scts-engineering/umptysquatch-10/electronics/new_electronics/new_electronics.pdf

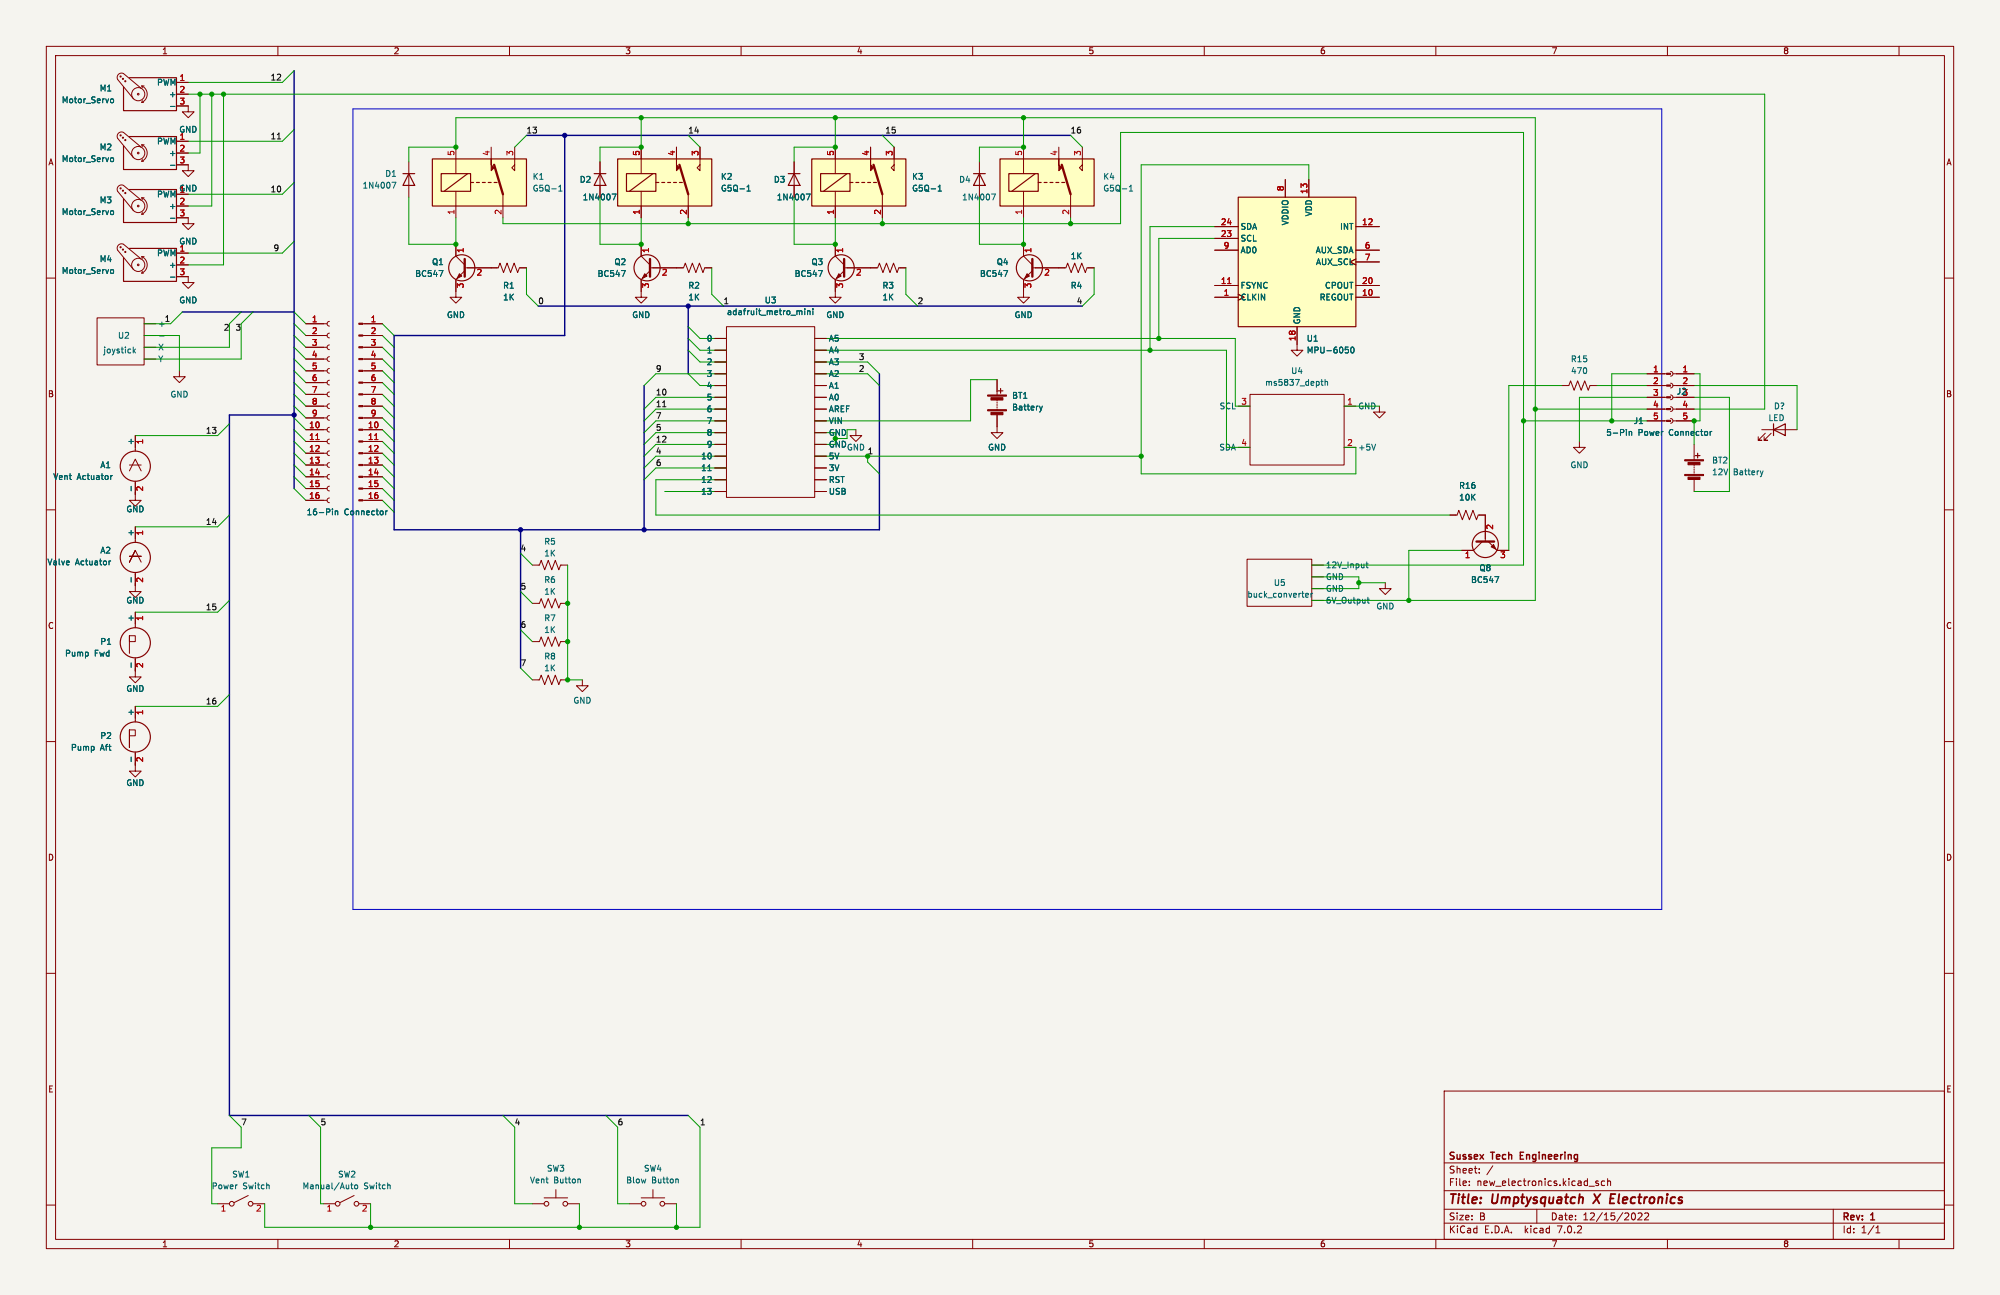
[picture p1: page 1]

Id: 1/1 Title: Umptysquatch X Electronics
