scts-engineering/umptysquatch-10/electronics/integrated_joystick_dac/integrated_joystick_dac.kicad_pcb

## KiCad design electronics/integrated_joystick_dac/integrated_joystick_dac.kicad_pcb (2023-05-17)

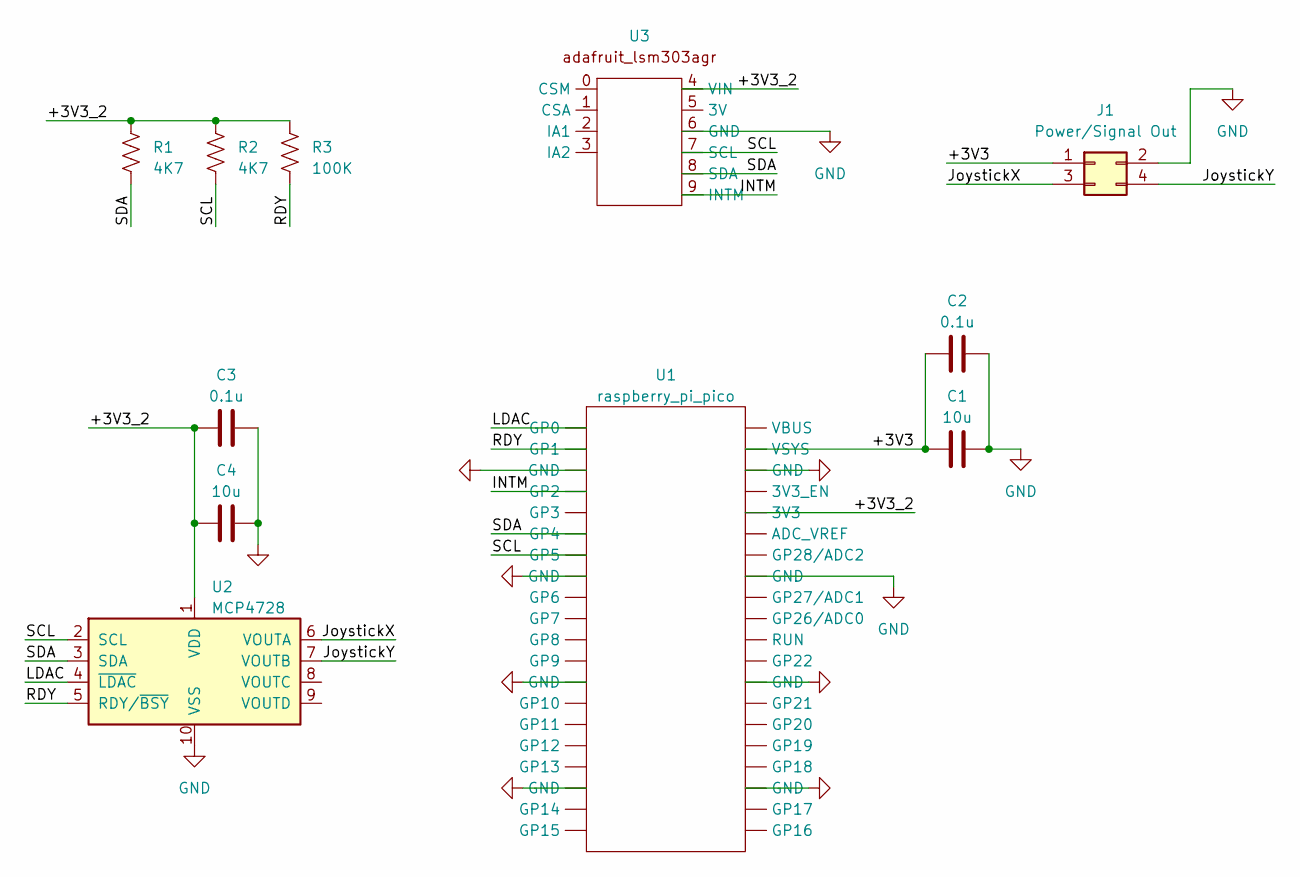
[picture p2: schematic integrated_joystick_dac.kicad_sch, Joystick DAC Board - Schematic]

Parts:
C1, C4: 10u; C_0603_1608Metric_Pad1.08x0.95mm_HandSolder
C2, C3: 0.1u; C_0402_1005Metric_Pad0.74x0.62mm_HandSolder
J1: Power/Signal Out; Molex_Mini-Fit_Jr_5569-04A2_2x02_P4.20mm_Horizontal
R1, R2: 4K7; R_Axial_DIN0207_L6.3mm_D2.5mm_P10.16mm_Horizontal
R3: 100K; R_Axial_DIN0207_L6.3mm_D2.5mm_P10.16mm_Horizontal
U1: raspberry_pi_pico
U2: MCP4728; MSOP-10_3x3mm_P0.5mm
U3: adafruit_lsm303agr

Connections:
/+3V3: C1.1, C2.1, J1.1, U1.39 (VSYS)
/+3V3_2: C3.1, C4.1, R1.1, R2.1, R3.1, U1.36 (3V3), U2.1 (VDD), U3.4 (VIN)
/INTM: U1.4 (GP2), U3.9 (INTM)
/JoystickX: J1.3, U2.6 (VOUTA)
/JoystickY: J1.4, U2.7 (VOUTB)
/LDAC: U1.1 (GP0), U2.4 (~LDAC)
/RDY: R3.2, U1.2 (GP1), U2.5 (RDY/~BSY)
/SCL: R2.2, U1.7 (GP5), U2.2 (SCL), U3.7 (SCL)
/SDA: R1.2, U1.6 (GP4), U2.3 (SDA), U3.8 (SDA)
GND: C1.2, C2.2, C3.2, C4.2, J1.2, U1.3 (GND), U1.8 (GND), U1.13 (GND), U1.18 (GND), U1.23 (GND), U1.28 (GND), U1.33 (GND), U1.38 (GND), U2.10 (VSS), U3.6 (GND)

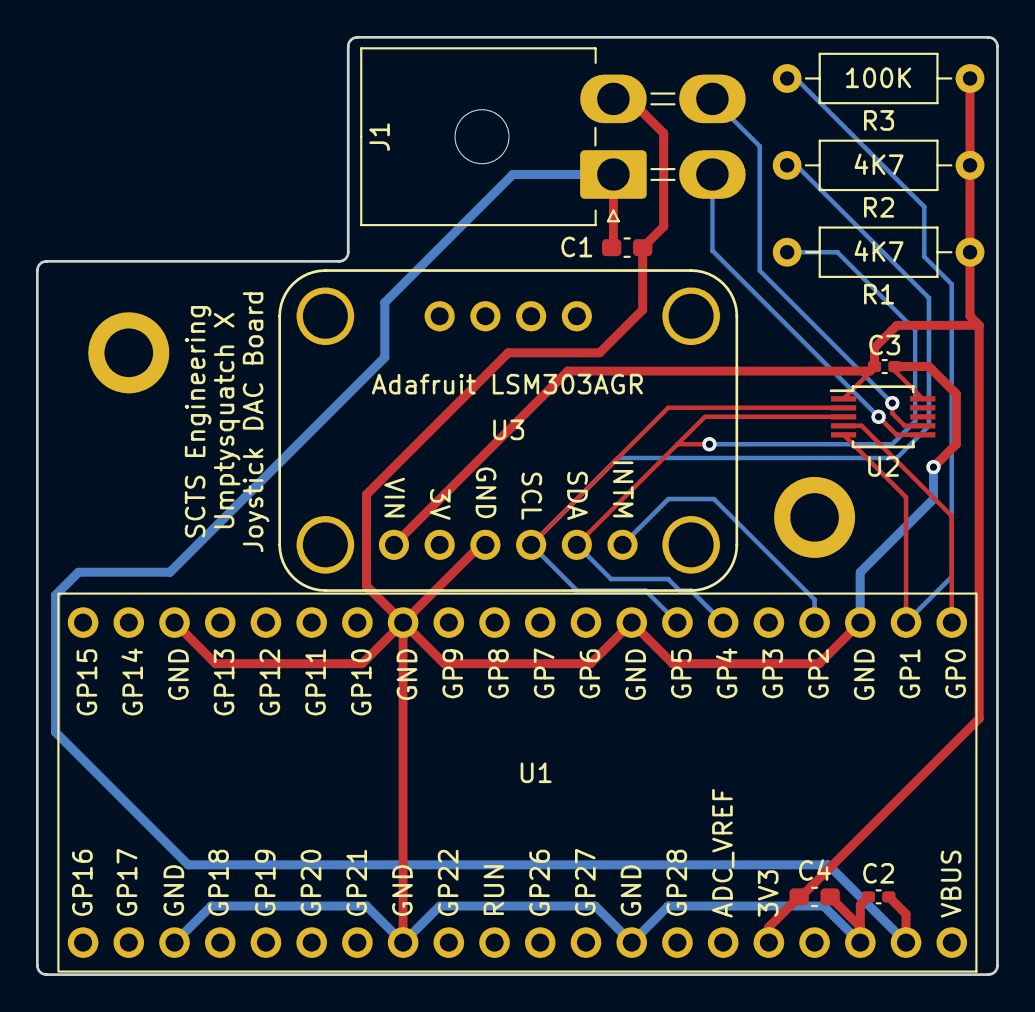
[picture p3: board integrated_joystick_dac.kicad_pcb from above]

Board: 2 copper layers, 53.3 x 52.1 mm, 11 parts (0 on the bottom side), 10 nets.
