scts-engineering/umptysquatch-10/electronics/v2_electronics/v2_electronics.kicad_pcb

## KiCad design electronics/v2_electronics/v2_electronics.kicad_pcb (2023-05-17)

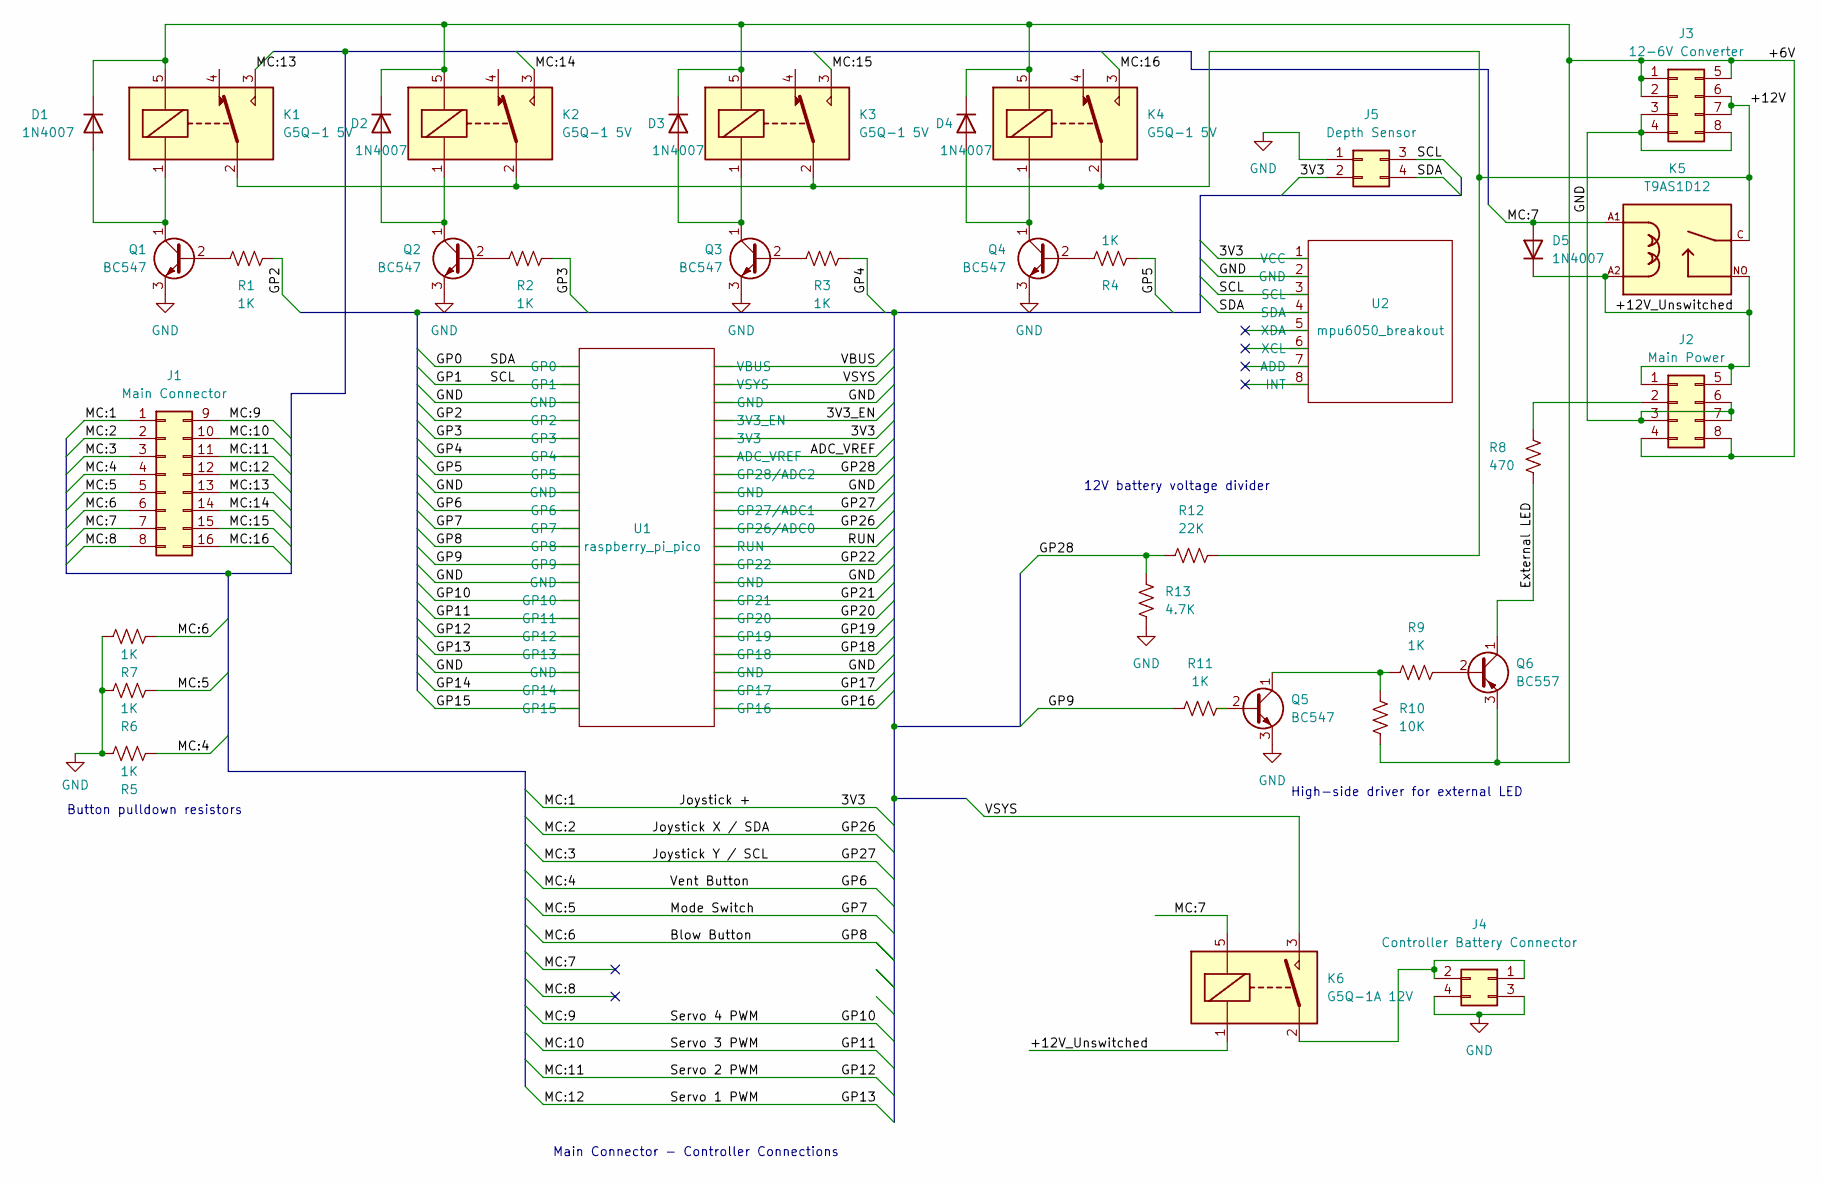
[picture p4: schematic v2_electronics.kicad_sch, Umptysquatch X Electronics]

Parts:
D1, D2, D3, D4: 1N4007; D_DO-41_SOD81_P12.70mm_Horizontal
D5: 1N4007; D_DO-41_SOD81_P10.16mm_Horizontal
J1: Main Connector; Molex_Mini-Fit_Jr_5569-16A2_2x08_P4.20mm_Horizontal
J2: Main Power; Molex_Mini-Fit_Jr_5569-08A2_2x04_P4.20mm_Horizontal
J3: 12-6V Converter; Molex_Mini-Fit_Jr_5569-08A2_2x04_P4.20mm_Horizontal
J4: Controller Battery Connector; Molex_Mini-Fit_Jr_5569-04A2_2x02_P4.20mm_Horizontal
J5: Depth Sensor; Molex_Mini-Fit_Jr_5569-04A2_2x02_P4.20mm_Horizontal
K1, K2, K3, K4: G5Q-1 5V; Relay_SPDT_Omron-G5Q-1
K5: T9AS1D12
K6: G5Q-1A 12V; Relay_SPST_Omron-G5Q-1A
Q1, Q2, Q3, Q4, Q5: BC547; TO-92_Inline
Q6: BC557; TO-92_Inline
R1, R2, R3, R4, R5, R6, R7, R9, R11: 1K; R_Axial_DIN0207_L6.3mm_D2.5mm_P10.16mm_Horizontal
R8: 470; R_Axial_DIN0207_L6.3mm_D2.5mm_P10.16mm_Horizontal
R10: 10K; R_Axial_DIN0207_L6.3mm_D2.5mm_P10.16mm_Horizontal
R12: 22K; R_Axial_DIN0207_L6.3mm_D2.5mm_P10.16mm_Horizontal
R13: 4.7K; R_Axial_DIN0207_L6.3mm_D2.5mm_P10.16mm_Horizontal
U1: raspberry_pi_pico
U2: mpu6050_breakout; mpu6050

Connections:
/3V3: J1.1, J5.2, U1.36 (3V3), U2.1 (VCC)
/3V3_EN: U1.37 (3V3_EN); also elsewhere on the board
/+6V: D1.1 (K), D2.1 (K), D3.1 (K), D4.1 (K), J2.4, J2.8, J3.1, J3.2, J3.5, K1.5, K2.5, K3.5, K4.5, Q6.3 (E), R10.1
/+12V: J3.6, J3.7, K1.2, K2.2, K3.2, K4.2, K5.C, R12.2
/+12V_Unswitched: D5.1 (K), J2.1, J2.5, K5.A2, K5.NO, K6.1
/ADC_VREF: U1.35 (ADC_VREF); also elsewhere on the board
/Blow Button: J1.6, R7.2, U1.11 (GP8)
/External LED: Q6.1 (C), R8.1
/GP0: J5.4, U1.1 (GP0), U2.4 (SDA)
/GP1: J5.3, U1.2 (GP1), U2.3 (SCL)
/GP2: R1.2, U1.4 (GP2)
/GP3: R2.2, U1.5 (GP3)
/GP4: R3.2, U1.6 (GP4)
/GP5: R4.2, U1.7 (GP5)
/GP6: J1.4, R5.2, U1.9 (GP6)
/GP7: J1.5, R6.2, U1.10 (GP7)
/GP9: R11.1, U1.12 (GP9)
/GP10: J1.9, U1.14 (GP10)
/GP11: J1.10, U1.15 (GP11)
/GP12: J1.11, U1.16 (GP12)
/GP13: J1.12, U1.17 (GP13)
/GP14: U1.19 (GP14); also elsewhere on the board
/GP15: U1.20 (GP15); also elsewhere on the board
/GP16: U1.21 (GP16); also elsewhere on the board
/GP17: U1.22 (GP17); also elsewhere on the board
/GP18: U1.24 (GP18); also elsewhere on the board
/GP19: U1.25 (GP19); also elsewhere on the board
/GP20: U1.26 (GP20); also elsewhere on the board
/GP21: U1.27 (GP21); also elsewhere on the board
/GP22: U1.29 (GP22); also elsewhere on the board
/GP26: J1.2, U1.31 (GP26/ADC0)
/GP27: J1.3, U1.32 (GP27/ADC1)
/GP28: R12.1, R13.2, U1.34 (GP28/ADC2)
/MC:7: D5.2 (A), J1.7, K5.A1, K6.5
/MC:8: J1.8
/MC:13: J1.13, K1.3
/MC:14: J1.14, K2.3
/MC:15: J1.15, K3.3
/MC:16: J1.16, K4.3
/RUN: U1.30 (RUN); also elsewhere on the board
/VBUS: U1.40 (VBUS); also elsewhere on the board
/VSYS: K6.3, U1.39 (VSYS)
GND: J2.3, J2.6, J2.7, J3.3, J3.4, J3.8, J4.3, J4.4, J5.1, Q1.3 (E), Q2.3 (E), Q3.3 (E), Q4.3 (E), Q5.3 (E), R5.1, R6.1, R7.1, R13.1, U1.3 (GND), U1.8 (GND), U1.13 (GND), U1.18 (GND), U1.23 (GND), U1.28 (GND), U1.33 (GND), U1.38 (GND), U2.2 (GND)
unnamed: D1.2 (A), K1.1, Q1.1 (C)
unnamed: D2.2 (A), K2.1, Q2.1 (C)
unnamed: D3.2 (A), K3.1, Q3.1 (C)
unnamed: D4.2 (A), K4.1, Q4.1 (C)
unnamed: J2.2, R8.2
unnamed: J4.1, J4.2, K6.2
unnamed: Q1.2 (B), R1.1
unnamed: Q2.2 (B), R2.1
unnamed: Q3.2 (B), R3.1
unnamed: Q4.2 (B), R4.1
unnamed: Q5.1 (C), R9.1, R10.2
unnamed: Q5.2 (B), R11.2
unnamed: Q6.2 (B), R9.2

Notes on the sheet:
12V battery voltage divider
Main Connector - Controller Connections
Button pulldown resistors
High-side driver for external LED

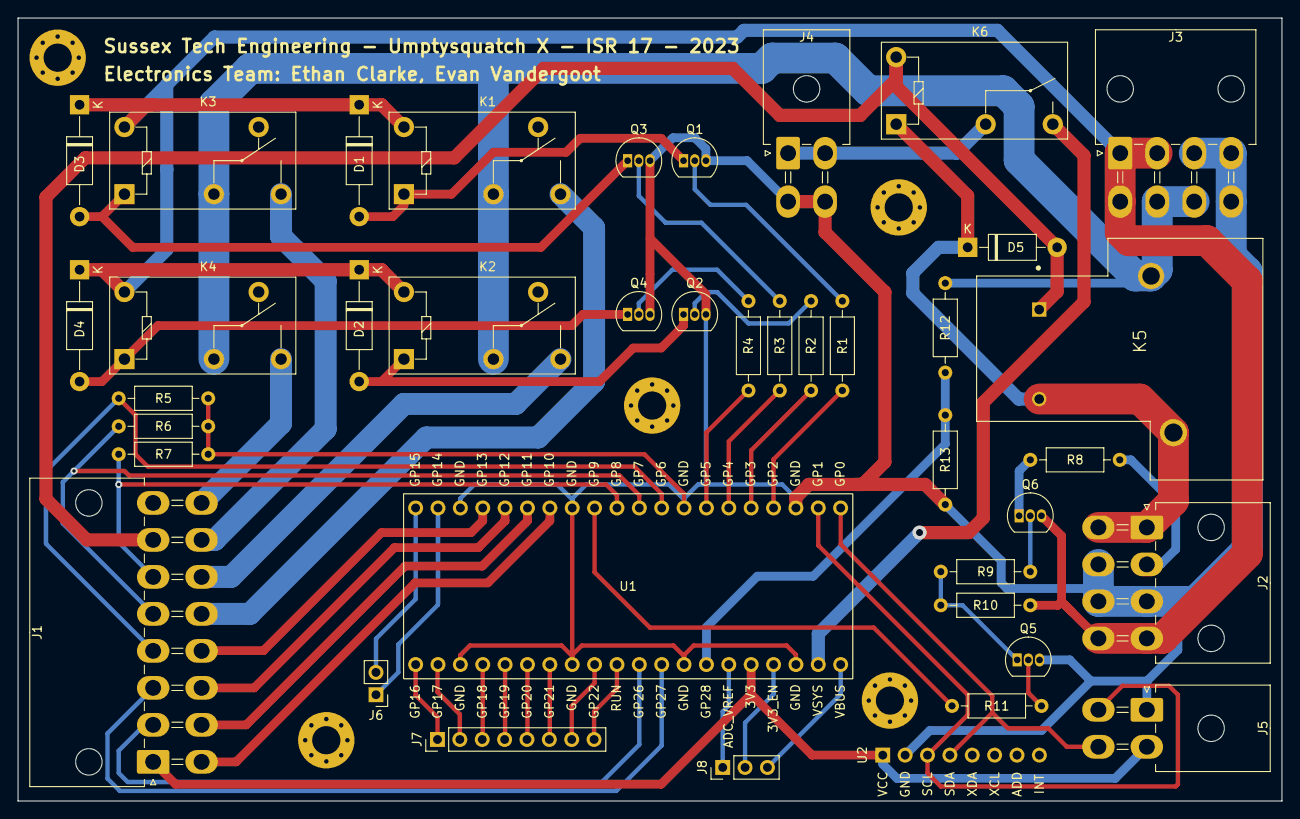
[picture p5: board v2_electronics.kicad_pcb from above]

Board: 2 copper layers, 143.5 x 88.9 mm, 40 parts (0 on the bottom side), 55 nets.

Other parts of the board:
J6: PinHeader_1x02_P2.54mm_Vertical
J7: PinHeader_1x08_P2.54mm_Vertical
J8: PinHeader_1x03_P2.54mm_Vertical

Their connections:
/3V3_EN: J8.2; also elsewhere on the board
/ADC_VREF: J8.1; also elsewhere on the board
/GP14: J6.1; also elsewhere on the board
/GP15: J6.2; also elsewhere on the board
/GP16: J7.1; also elsewhere on the board
/GP17: J7.2; also elsewhere on the board
/GP18: J7.3; also elsewhere on the board
/GP19: J7.4; also elsewhere on the board
/GP20: J7.5; also elsewhere on the board
/GP21: J7.6; also elsewhere on the board
/GP22: J7.7; also elsewhere on the board
/RUN: J7.8; also elsewhere on the board
/VBUS: J8.3; also elsewhere on the board
