scts-engineering/umptysquatch-10/electronics/joystick_dac/joystick_dac.kicad_pcb

## KiCad design electronics/joystick_dac/joystick_dac.kicad_pcb (2023-05-08)

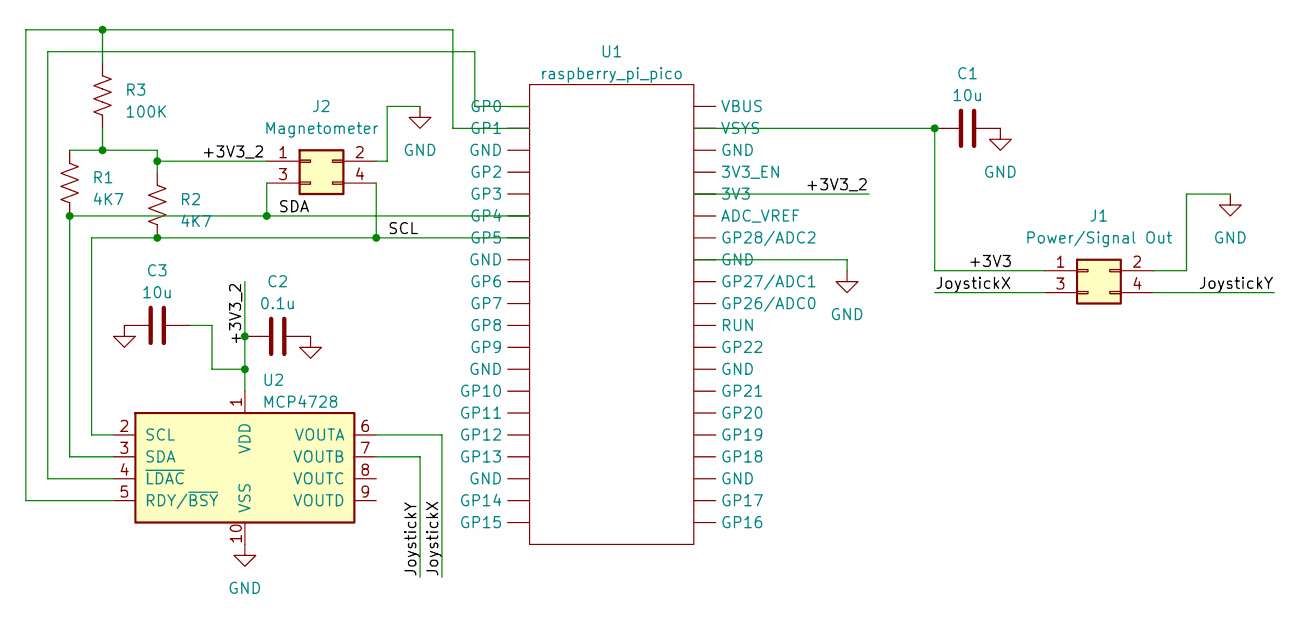
[picture p6: schematic joystick_dac.kicad_sch]

Parts:
C1, C3: 10u; C_0603_1608Metric_Pad1.08x0.95mm_HandSolder
C2: 0.1u; C_0402_1005Metric_Pad0.74x0.62mm_HandSolder
J1: Power/Signal Out; Molex_Mini-Fit_Jr_5569-04A2_2x02_P4.20mm_Horizontal
J2: Magnetometer; Molex_Mini-Fit_Jr_5569-04A2_2x02_P4.20mm_Horizontal
R1, R2: 4K7; R_Axial_DIN0207_L6.3mm_D2.5mm_P10.16mm_Horizontal
R3: 100K; R_Axial_DIN0207_L6.3mm_D2.5mm_P10.16mm_Horizontal
U1: raspberry_pi_pico
U2: MCP4728; MSOP-10_3x3mm_P0.5mm

Connections:
/+3V3: C1.1, J1.1, U1.39 (VSYS)
/+3V3_2: C2.1, C3.2, J2.1, R1.1, R2.1, R3.2, U1.36 (3V3), U2.1 (VDD)
/JoystickX: J1.3, U2.6 (VOUTA)
/JoystickY: J1.4, U2.7 (VOUTB)
/SCL: J2.4, R2.2, U1.7 (GP5), U2.2 (SCL)
/SDA: J2.3, R1.2, U1.6 (GP4), U2.3 (SDA)
GND: C1.2, C2.2, C3.1, J1.2, J2.2, U1.33 (GND), U2.10 (VSS)
unnamed: U1.1 (GP0), U2.4 (~LDAC)
unnamed: R3.1, U1.2 (GP1), U2.5 (RDY/~BSY)

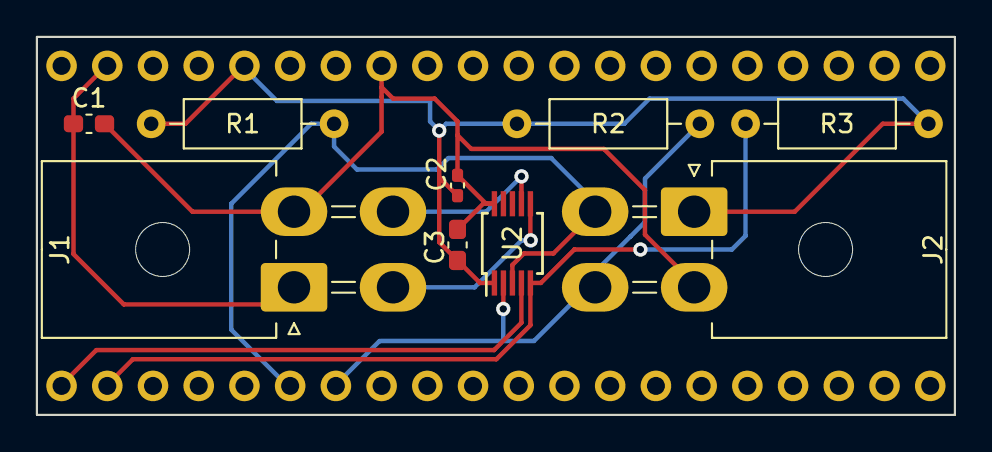
[picture p7: board joystick_dac.kicad_pcb from above]

Board: 2 copper layers, 51.0 x 21.0 mm, 10 parts (0 on the bottom side), 9 nets.
