scts-engineering/umptysquatch-10/code/u-10_code/sub-new-pi/buttons.h

#include <Arduino.h>

typedef struct DebouncedSwitch {
    long debounceDelay;
    int buttonState;
    int lastButtonState;
    int reading;
        
    int pinNum;
    // the function to run when state changes, with the int holding the new state
    void (*callback)(int);
} DebouncedSwitch;

void attachSwitch(DebouncedSwitch *sw, int pinNum, int debounceDelay, void (*callback)(int));

// returns true when there is a CHANGE in state,
// also runs the callback in the DebouncedSwitch
boolean tickSwitch(DebouncedSwitch *sw);
