scts-engineering/umptysquatch-10/(commit log)

2022-12-02 add remade old schematic
    [submarine.kicad_pcb, submarine.kicad_sch]
2022-12-02 make copy for new schematic and pcb
    [new_electronics.kicad_pcb, new_electronics.kicad_sch]
2022-12-05 'complete' old schematic and work on new one
    [new_electronics.kicad_sch, submarine.kicad_sch]
2022-12-06 more work on new schematic
    [new_electronics.kicad_sch, submarine.kicad_sch]
2022-12-07 work on new pcb
    [new_electronics.kicad_pcb, new_electronics.kicad_sch]
2022-12-09 some basic wiring for new pcb
    [new_electronics.kicad_pcb]
2022-12-11 more new pcb work
    [new_electronics.kicad_pcb, new_electronics.kicad_sch]
2022-12-14 'finished' new pcb
    [new_electronics.kicad_pcb]
2022-12-15 small changes still to new pcb
    [new_electronics.kicad_pcb]
2022-12-16 arduino wants sub-new.ino in a folder called sub-new
2022-12-22 do some stuff with steering and find out blocking code in mpu6050
2023-01-05 added some depth sensor stuff
2023-01-06 more work joystick magnet stuff
2023-01-10 pin selection and sucessful depth sensor tests
2023-01-13 organize folders
    [new_electronics.kicad_pcb, new_electronics.kicad_sch, submarine.kicad_pcb, submarine.kicad_sch]
2023-01-13 the servos and x pattern are good now
2023-01-18 added start to led test
2023-01-19 finished led example
2023-01-20 added led to main file
2023-01-30 led stuff
2023-02-03 button testing stuff
2023-02-03 fixed button pin numbers
    [sub-new.ino, submarine.h]
2023-02-05 added auto and manual mode switching
2023-02-06 Work on button switch system
2023-02-06 add magnetometer joystick test to git (for joystickrep)
2023-02-27 pico combatibility
2023-02-27 remove useless prints to console
2023-03-01 start v2 electronics schematic
    [v2_electronics.kicad_pcb, v2_electronics.kicad_sch]
2023-03-01 more work v2 electronics
    [v2_electronics.kicad_sch]
2023-03-03 switch debouncing
2023-03-08 more pcb v2 work:
    [v2_electronics.kicad_sch]
2023-03-09 more work on schematic v2
    [v2_electronics.kicad_sch]
2023-03-09 more work on v2 schematic:
    [v2_electronics.kicad_sch]
2023-03-11 start v2 pcb
    [v2_electronics.kicad_pcb, v2_electronics.kicad_sch]
2023-03-13 do most of the work on v2 pcb
    [v2_electronics.kicad_pcb, v2_electronics.kicad_sch]
2023-03-14 maybe do some work on the v2 pcb
    [v2_electronics.kicad_pcb, v2_electronics.kicad_sch]
2023-03-21 'finish' pcbv2, waiting for logo...
    [v2_electronics.kicad_pcb, v2_electronics.kicad_sch]
2023-03-27 electronics final final?
    [v2_electronics.kicad_pcb, v2_electronics.kicad_sch]
2023-03-29 add logo to pcb
    [v2_electronics.kicad_pcb]
2023-05-06 begin dac thing for joystick
    [joystick_dac.kicad_pcb, joystick_dac.kicad_sch]
2023-05-07 quick prototype of dac board for joystick
    [joystick_dac.kicad_pcb, joystick_dac.kicad_sch]
2023-05-08 work on integrated joystick pcb thing
    [integrated_joystick_dac-B_Cu.gbr, integrated_joystick_dac-B_Mask.gbr, integrated_joystick_dac-B_Paste.gbr, integrated_joystick_dac-B_Silkscreen.gbr, integrated_joystick_dac-Edge_Cuts.gbr, integrated_joystick_dac-F_Cu.gbr, integrated_joystick_dac-F_Mask.gbr, integrated_joystick_dac-F_Paste.gbr]
2023-05-08 start redoing board since it's too big
    [OLDintegrated_joystick_dac.kicad_pcb, OLDintegrated_joystick_dac.kicad_sch, integrated_joystick_dac.kicad_pcb]
2023-05-09 make smaller board...
    [integrated_joystick_dac.kicad_pcb, integrated_joystick_dac.kicad_sch]
2023-05-09 move connector back (probably too far)
    [integrated_joystick_dac.kicad_pcb]
2023-05-09 cutout for connector
    [integrated_joystick_dac.kicad_pcb]
2023-05-12 added new pcb code, and cleaned old file
2023-05-17 modify pcb and schematic sheets for export for design report
    [integrated_joystick_dac.kicad_pcb, integrated_joystick_dac.kicad_sch, new_electronics.kicad_pcb, new_electronics.kicad_sch, v2_electronics.kicad_pcb, v2_electronics.kicad_sch]
2023-06-12 a lot of various improvements and fixes
    [Moving_Average.h, joystick_dac.ino, sub-new-pi.ino, submarine.h]
